anss0907/Self_Balancing_Robot_With_ROS2_using_LQR_Controller/grace_description/meshes/imu_link.STL

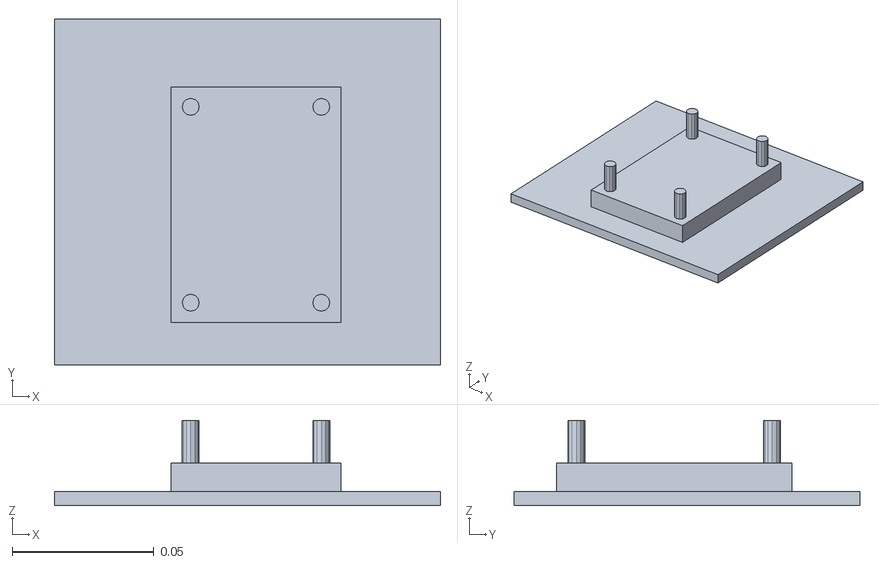
[picture p1: CAD file, 2026-02-27]
grace_description/meshes/imu_link.STL
0.136 x 0.122 x 0.03
