anss0907/Self_Balancing_Robot_With_ROS2_using_LQR_Controller/grace_description/meshes/wheel_left_link.STL

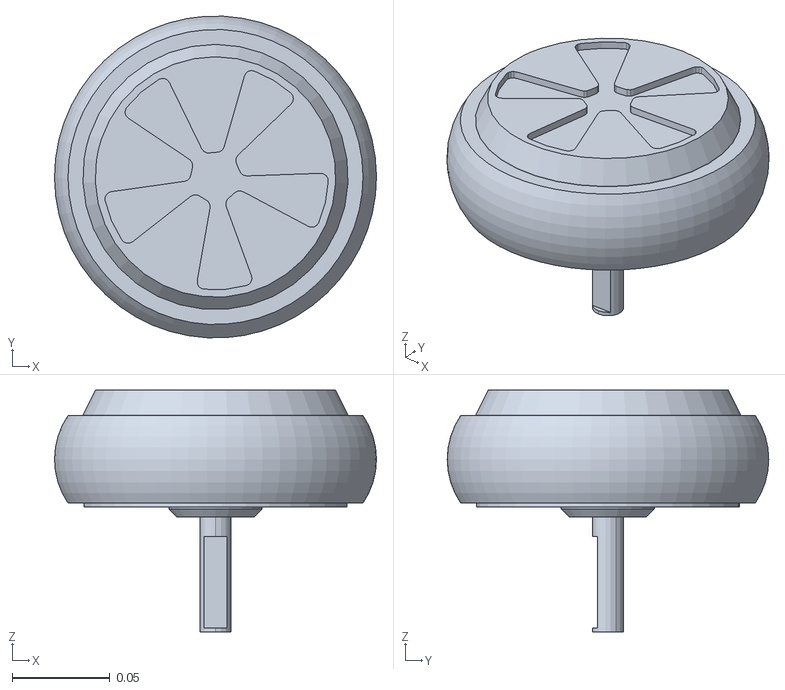
[picture p2: CAD file, 2026-02-27]
grace_description/meshes/wheel_left_link.STL
0.165 x 0.165 x 0.124
