anss0907/Self_Balancing_Robot_With_ROS2_using_LQR_Controller/grace_description/meshes/caster_front_link.STL

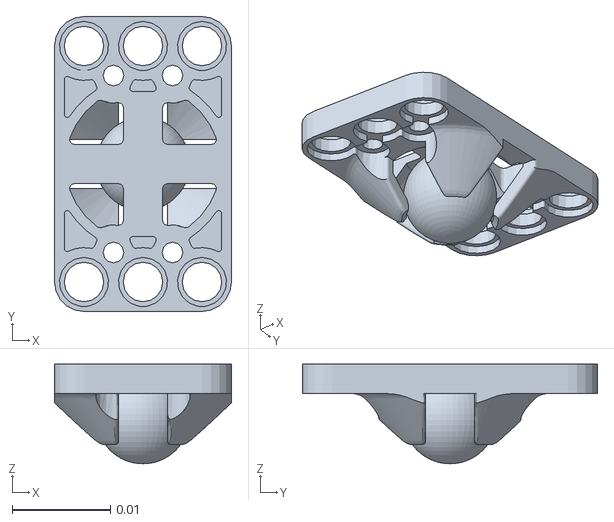
[picture p3: CAD file, 2026-02-27]
grace_description/meshes/caster_front_link.STL
0.018 x 0.03 x 0.0101
