anss0907/Self_Balancing_Robot_With_ROS2_using_LQR_Controller/grace_description/meshes/laser_link.STL

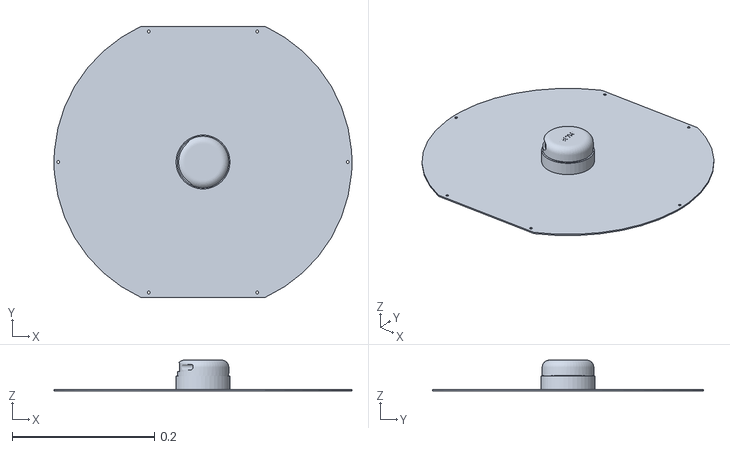
[picture p4: CAD file, 2026-02-27]
grace_description/meshes/laser_link.STL
0.418 x 0.381 x 0.0433
