anss0907/Self_Balancing_Robot_With_ROS2_using_LQR_Controller/grace_description/meshes/base_link.STL

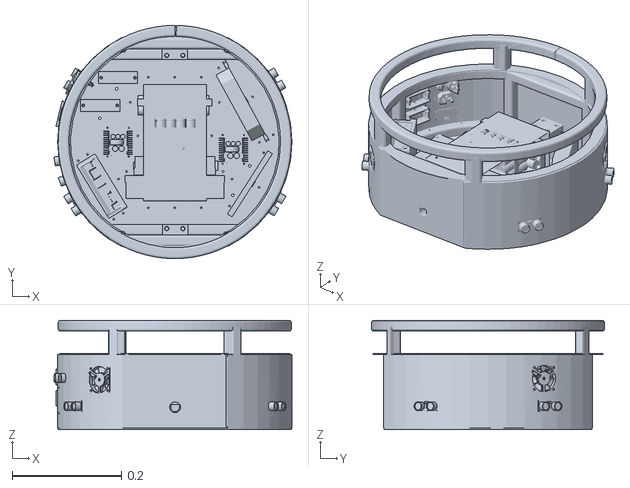
[picture p5: CAD file, 2026-02-27]
grace_description/meshes/base_link.STL
0.435 x 0.426 x 0.2
