anss0907/Self_Balancing_Robot_With_ROS2_using_LQR_Controller/(list of files, cad)

Other CAD files:
grace_description/meshes/caster_rear_link.STL
