anss0907/Self_Balancing_Robot_With_ROS2_using_LQR_Controller/(notices)

Notices in the files:
README.md:
License: Apache 2.0
